maxwelllllllllllll/MH69/Images/CB70 Matrix.png

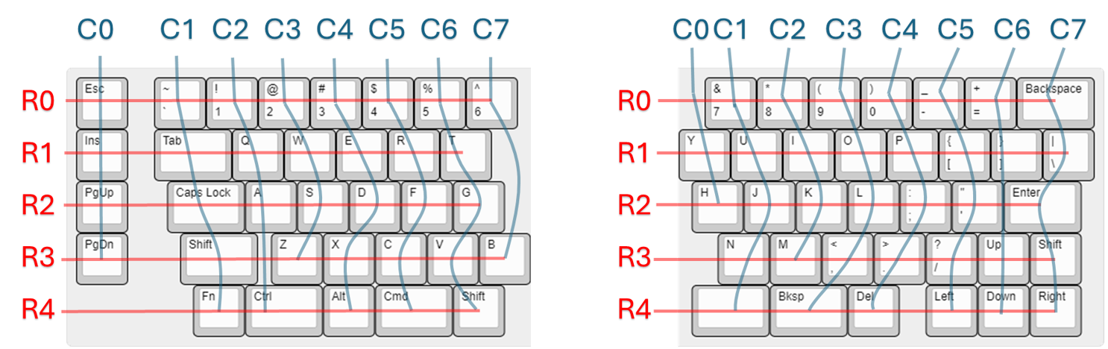
Images/CB70 Matrix.png
