maxwelllllllllllll/MH69/Images/DoubleKeys.png

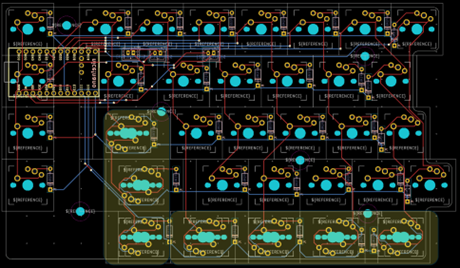
Images/DoubleKeys.png
