maxwelllllllllllll/MH69/Original CB70 Data/Case/Choc-Slim/pic.png

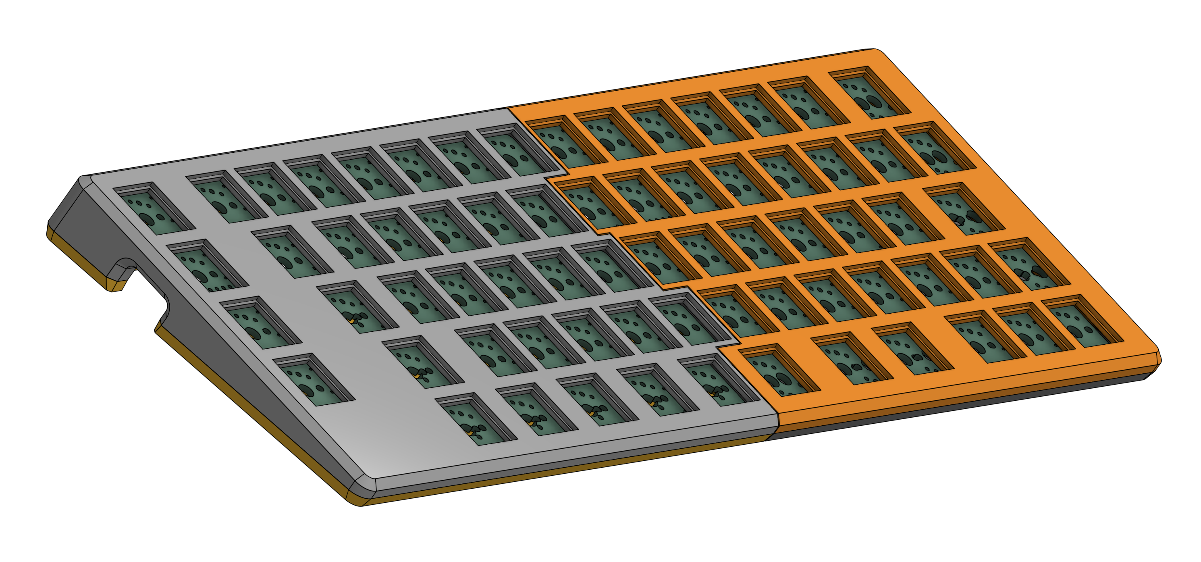
Original CB70 Data/Case/Choc-Slim/pic.png
