maxwelllllllllllll/MH69/Original CB70 Data/Case/Choc/pic.png

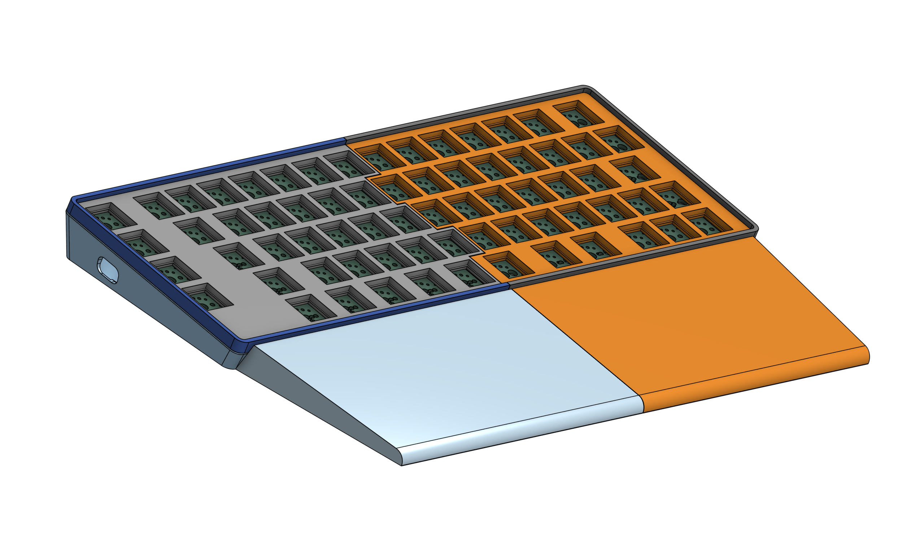
Original CB70 Data/Case/Choc/pic.png
