maxwelllllllllllll/MH69/Original CB70 Data/Case/MX/pic.png

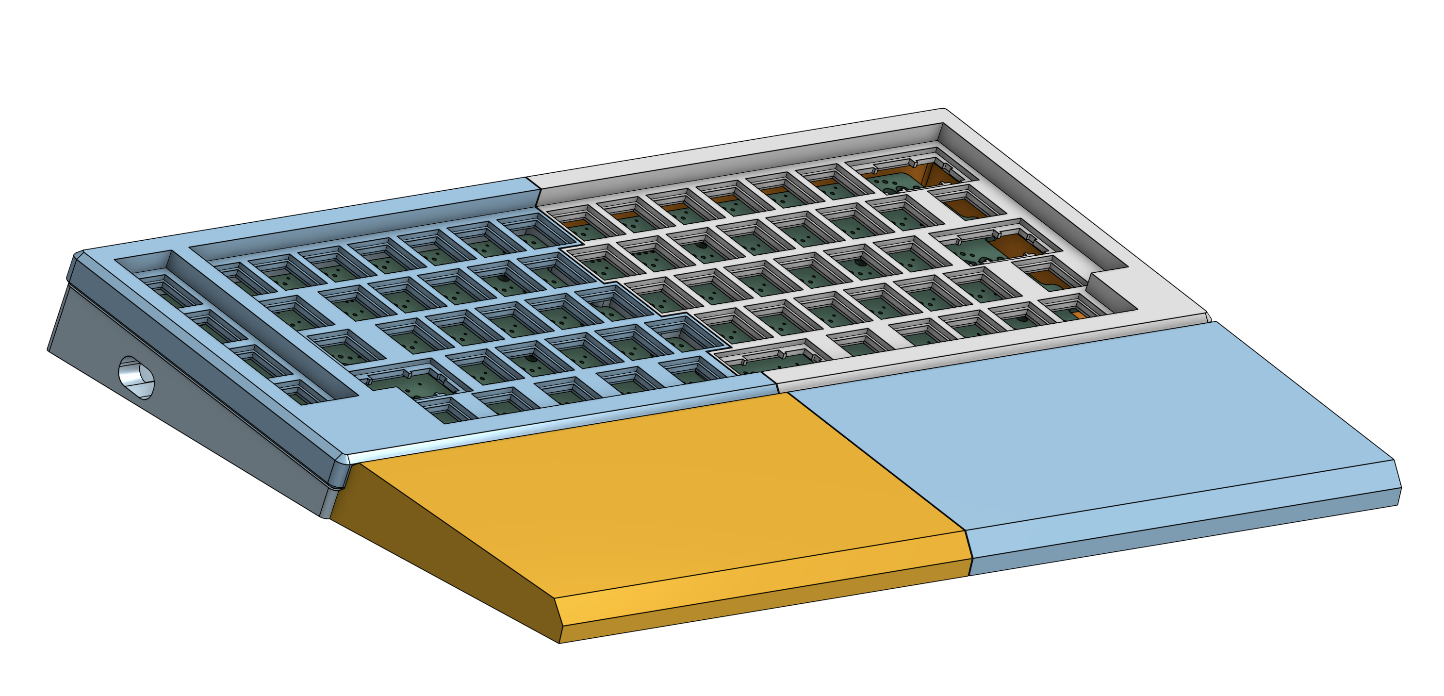
Original CB70 Data/Case/MX/pic.png
