maxwelllllllllllll/MH69/MH69_Data/PCB/MH69-Left/MH69-Left.step

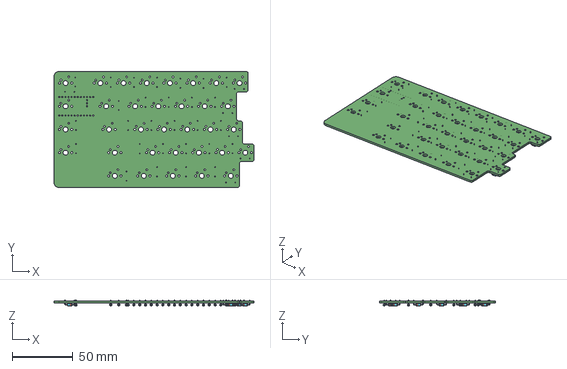
[picture p10: CAD file, 2025-01-18]
MH69_Data/PCB/MH69-Left/MH69-Left.step
164.3 x 95.2 x 5.01 mm
