maxwelllllllllllll/MH69/MH69_Data/PCB/MH69-Right/MH69-Right.step

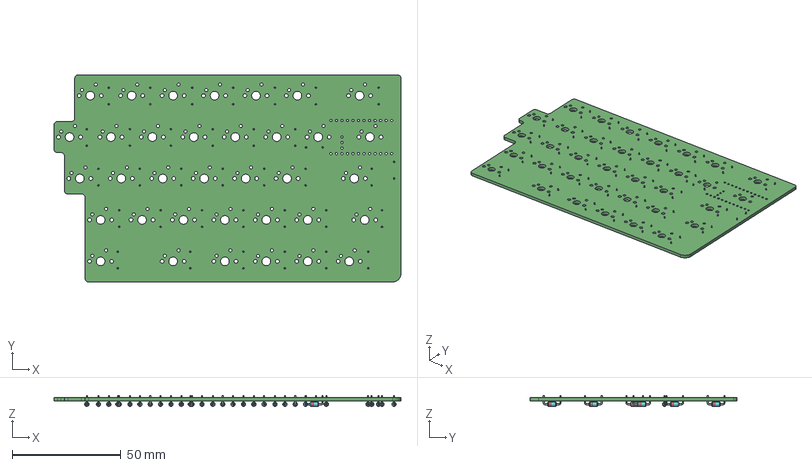
[picture p11: CAD file, 2025-01-18]
MH69_Data/PCB/MH69-Right/MH69-Right.step
159.5 x 95.2 x 5.01 mm
