maxwelllllllllllll/MH69/Original CB70 Data/Case/Choc-Slim/Choc-Slim - Right Plate.stl

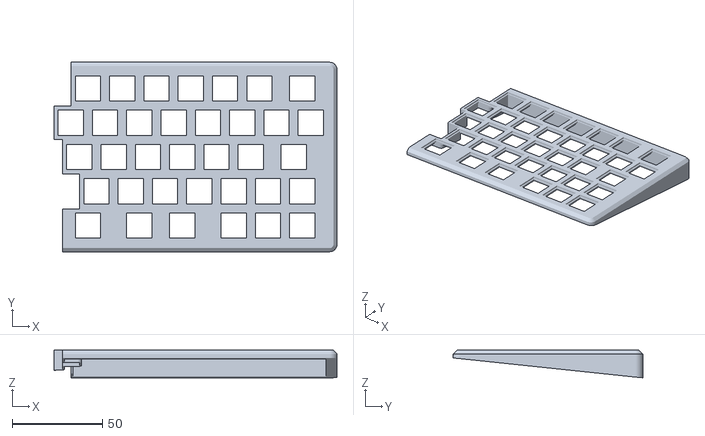
[picture p12: CAD file, 2025-01-18]
Original CB70 Data/Case/Choc-Slim/Choc-Slim - Right Plate.stl
156.8 x 105.0 x 15.4
