maxwelllllllllllll/MH69/Original CB70 Data/Case/Choc/Choc - Left Base.stl

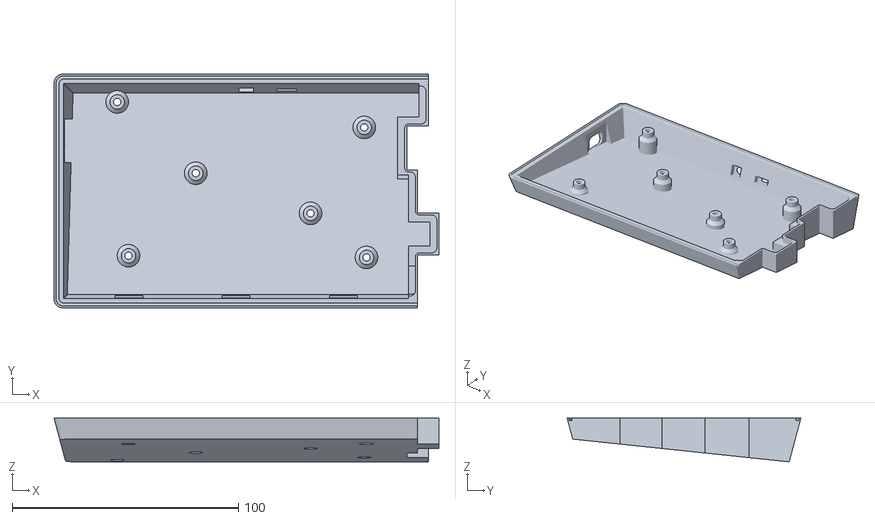
[picture p13: CAD file, 2025-01-18]
Original CB70 Data/Case/Choc/Choc - Left Base.stl
170.3 x 103.4 x 19.3
