maxwelllllllllllll/MH69/Original CB70 Data/Case/MX/MX - Left Top.stl

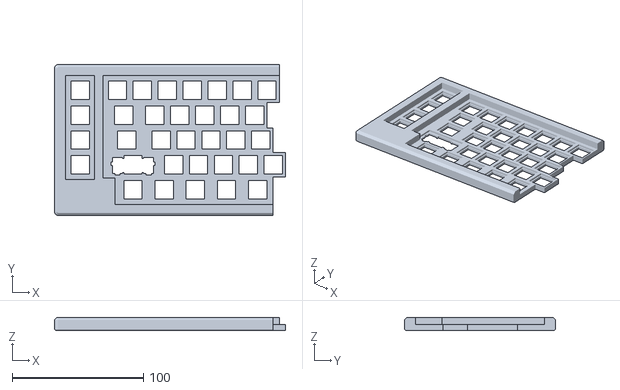
[picture p14: CAD file, 2025-01-18]
Original CB70 Data/Case/MX/MX - Left Top.stl
176.1 x 115.0 x 10.2
