maxwelllllllllllll/MH69/Original CB70 Data/Case/Choc/Choc - Left Plate.stl

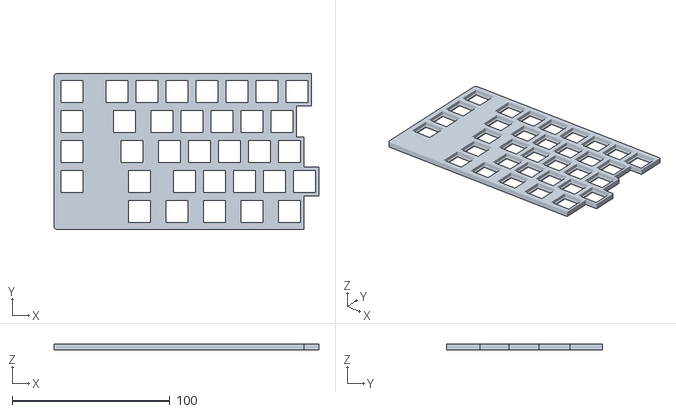
[picture p16: CAD file, 2025-01-18]
Original CB70 Data/Case/Choc/Choc - Left Plate.stl
168.1 x 99.0 x 3.80
