maxwelllllllllllll/MH69/Original CB70 Data/Case/MX/MX - Right Base.stl

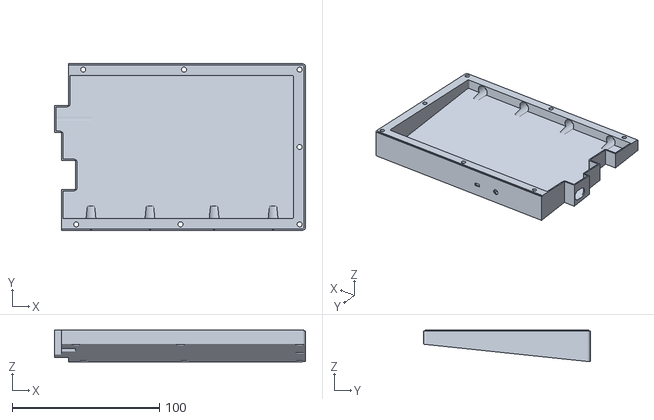
[picture p17: CAD file, 2025-01-18]
Original CB70 Data/Case/MX/MX - Right Base.stl
170.3 x 113.0 x 21.4
