maxwelllllllllllll/MH69/Original CB70 Data/Case/Choc-Slim/Choc-Slim - Right Base.stl

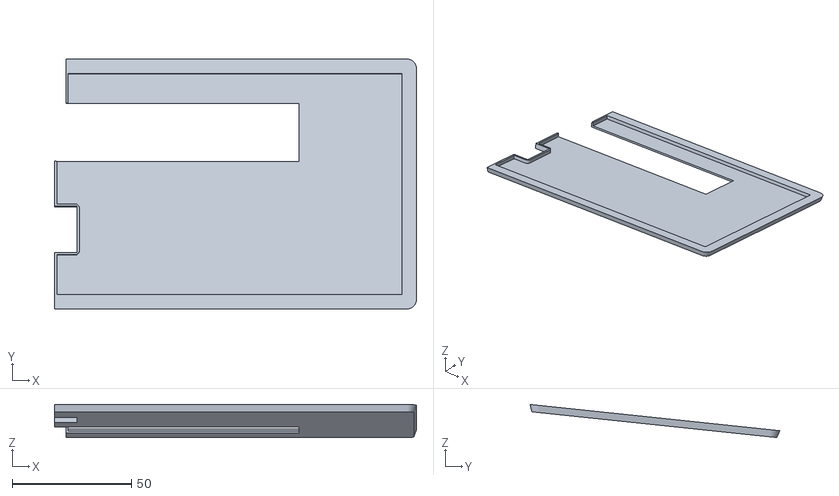
[picture p18: CAD file, 2025-01-18]
Original CB70 Data/Case/Choc-Slim/Choc-Slim - Right Base.stl
152.1 x 105.0 x 13.9
