maxwelllllllllllll/MH69/Original CB70 Data/Case/Choc/Choc - Right Top.stl

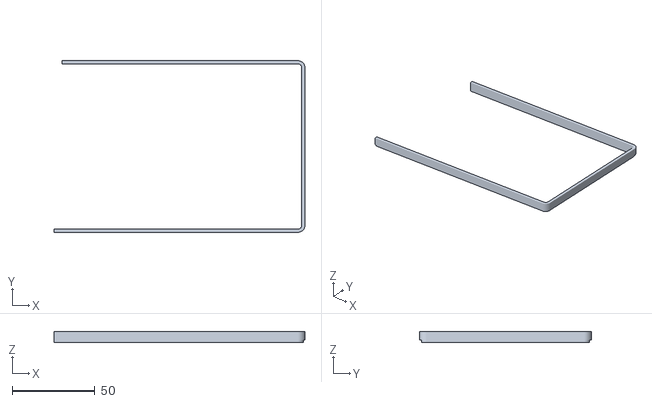
[picture p19: CAD file, 2025-01-18]
Original CB70 Data/Case/Choc/Choc - Right Top.stl
151.2 x 103.4 x 6.80
