maxwelllllllllllll/MH69/Original CB70 Data/Case/MX/MX - Left Base.stl

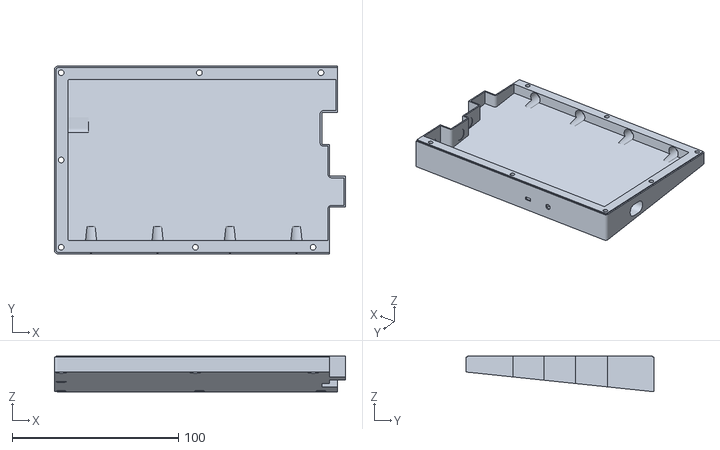
[picture p20: CAD file, 2025-01-18]
Original CB70 Data/Case/MX/MX - Left Base.stl
175.1 x 113.0 x 21.4
