maxwelllllllllllll/MH69/Original CB70 Data/Case/Choc-Slim/Choc-Slim - Left Plate.stl

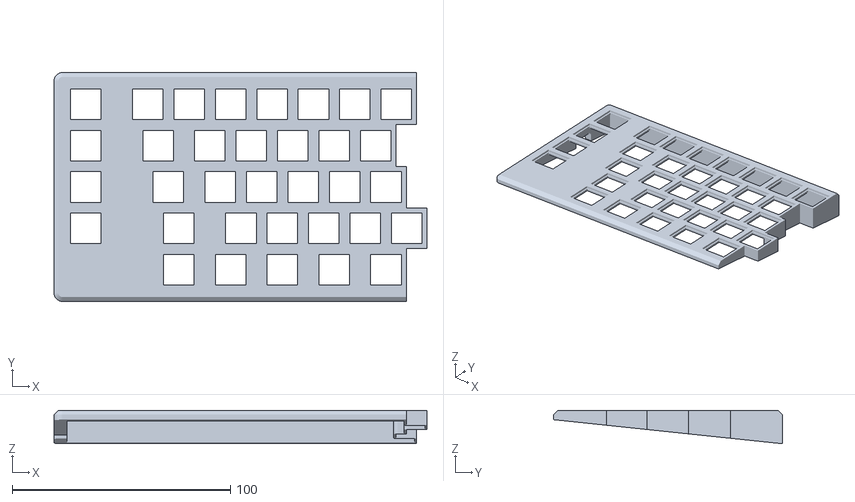
[picture p21: CAD file, 2025-01-18]
Original CB70 Data/Case/Choc-Slim/Choc-Slim - Left Plate.stl
171.1 x 105.0 x 15.4
