maxwelllllllllllll/MH69/Original CB70 Data/Case/Choc/Choc - Right base.stl

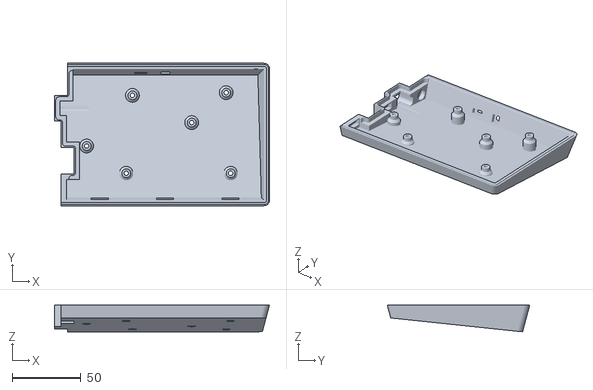
[picture p22: CAD file, 2025-01-18]
Original CB70 Data/Case/Choc/Choc - Right base.stl
156.0 x 103.4 x 19.3
