maxwelllllllllllll/MH69/Original CB70 Data/Case/MX/MX - Right Top.stl

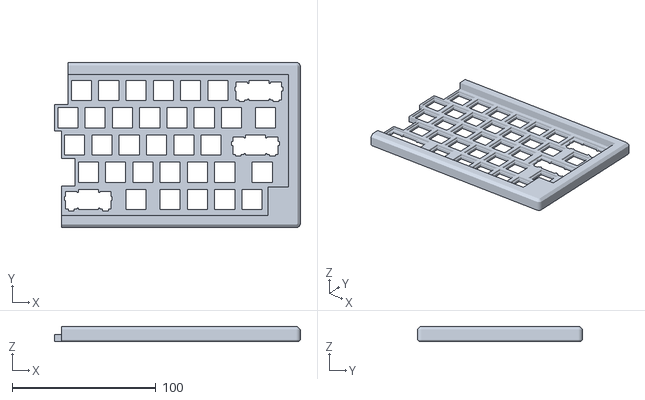
[picture p23: CAD file, 2025-01-18]
Original CB70 Data/Case/MX/MX - Right Top.stl
171.3 x 115.0 x 10.2
