maxwelllllllllllll/MH69/Original CB70 Data/Case/Choc/Choc - Right Wrist Rest.stl

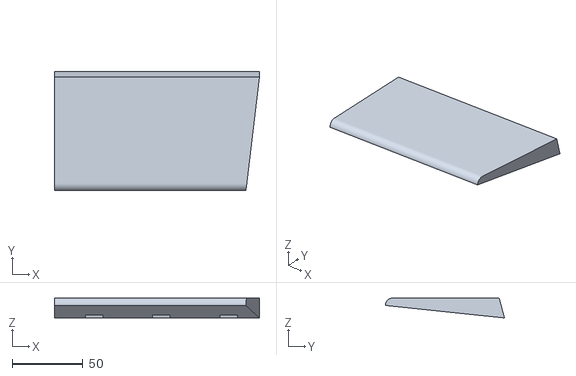
[picture p24: CAD file, 2025-01-18]
Original CB70 Data/Case/Choc/Choc - Right Wrist Rest.stl
144.7 x 84.0 x 14.1
