maxwelllllllllllll/MH69/Original CB70 Data/Case/MX/MX - Left Wrist Rest.stl

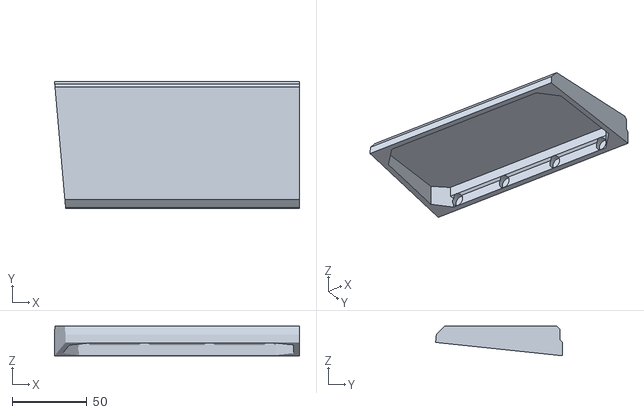
[picture p25: CAD file, 2025-01-18]
Original CB70 Data/Case/MX/MX - Left Wrist Rest.stl
163.6 x 84.7 x 19.7
