maxwelllllllllllll/MH69/Original CB70 Data/Case/Choc/Choc - Left Top.stl

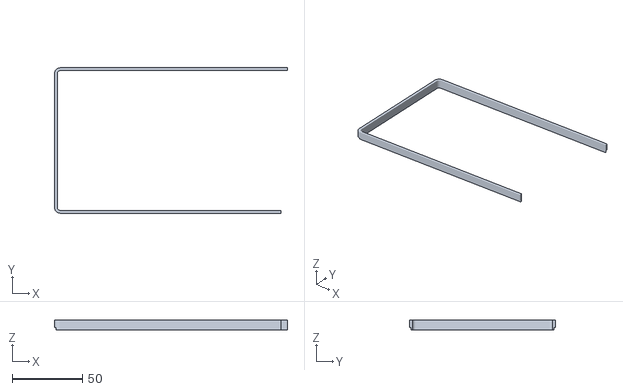
[picture p26: CAD file, 2025-01-18]
Original CB70 Data/Case/Choc/Choc - Left Top.stl
165.5 x 103.4 x 6.80
