maxwelllllllllllll/MH69/Original CB70 Data/Case/MX/MX - Right Wrist Rest.stl

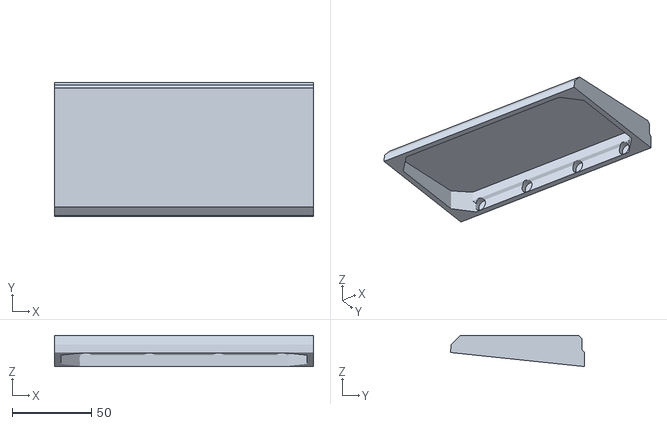
[picture p27: CAD file, 2025-01-18]
Original CB70 Data/Case/MX/MX - Right Wrist Rest.stl
163.6 x 84.7 x 19.7
