maxwelllllllllllll/MH69/Original CB70 Data/Case/Choc/Choc - Left Wrist Rest.stl

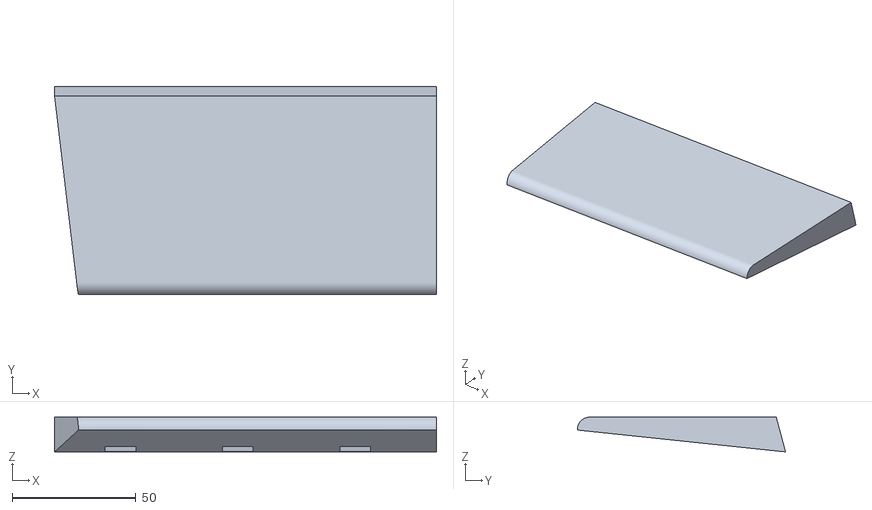
[picture p28: CAD file, 2025-01-18]
Original CB70 Data/Case/Choc/Choc - Left Wrist Rest.stl
154.2 x 84.0 x 14.1
