maxwelllllllllllll/MH69/Original CB70 Data/Case/Choc/Choc - Right Plate.stl

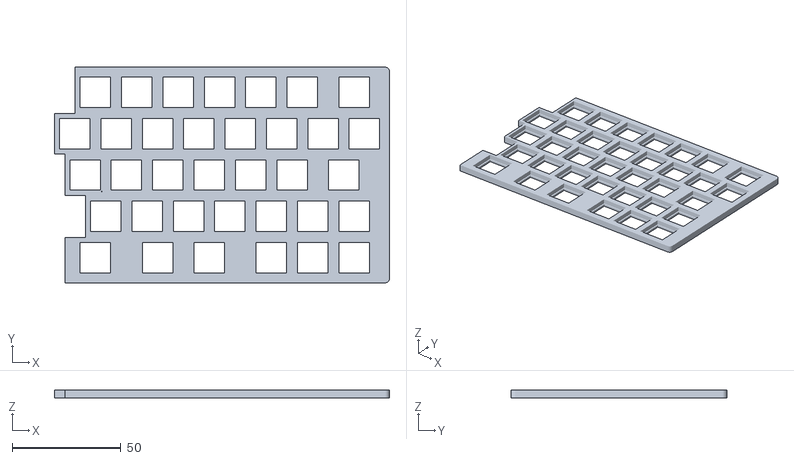
[picture p29: CAD file, 2025-01-18]
Original CB70 Data/Case/Choc/Choc - Right Plate.stl
153.8 x 99.0 x 3.80
