maxwelllllllllllll/MH69/MH69_Data/PCB/MH69-Right/MH69-Right.kicad_pcb

## KiCad design MH69_Data/PCB/MH69-Right/MH69-Right.kicad_pcb (2025-01-29)

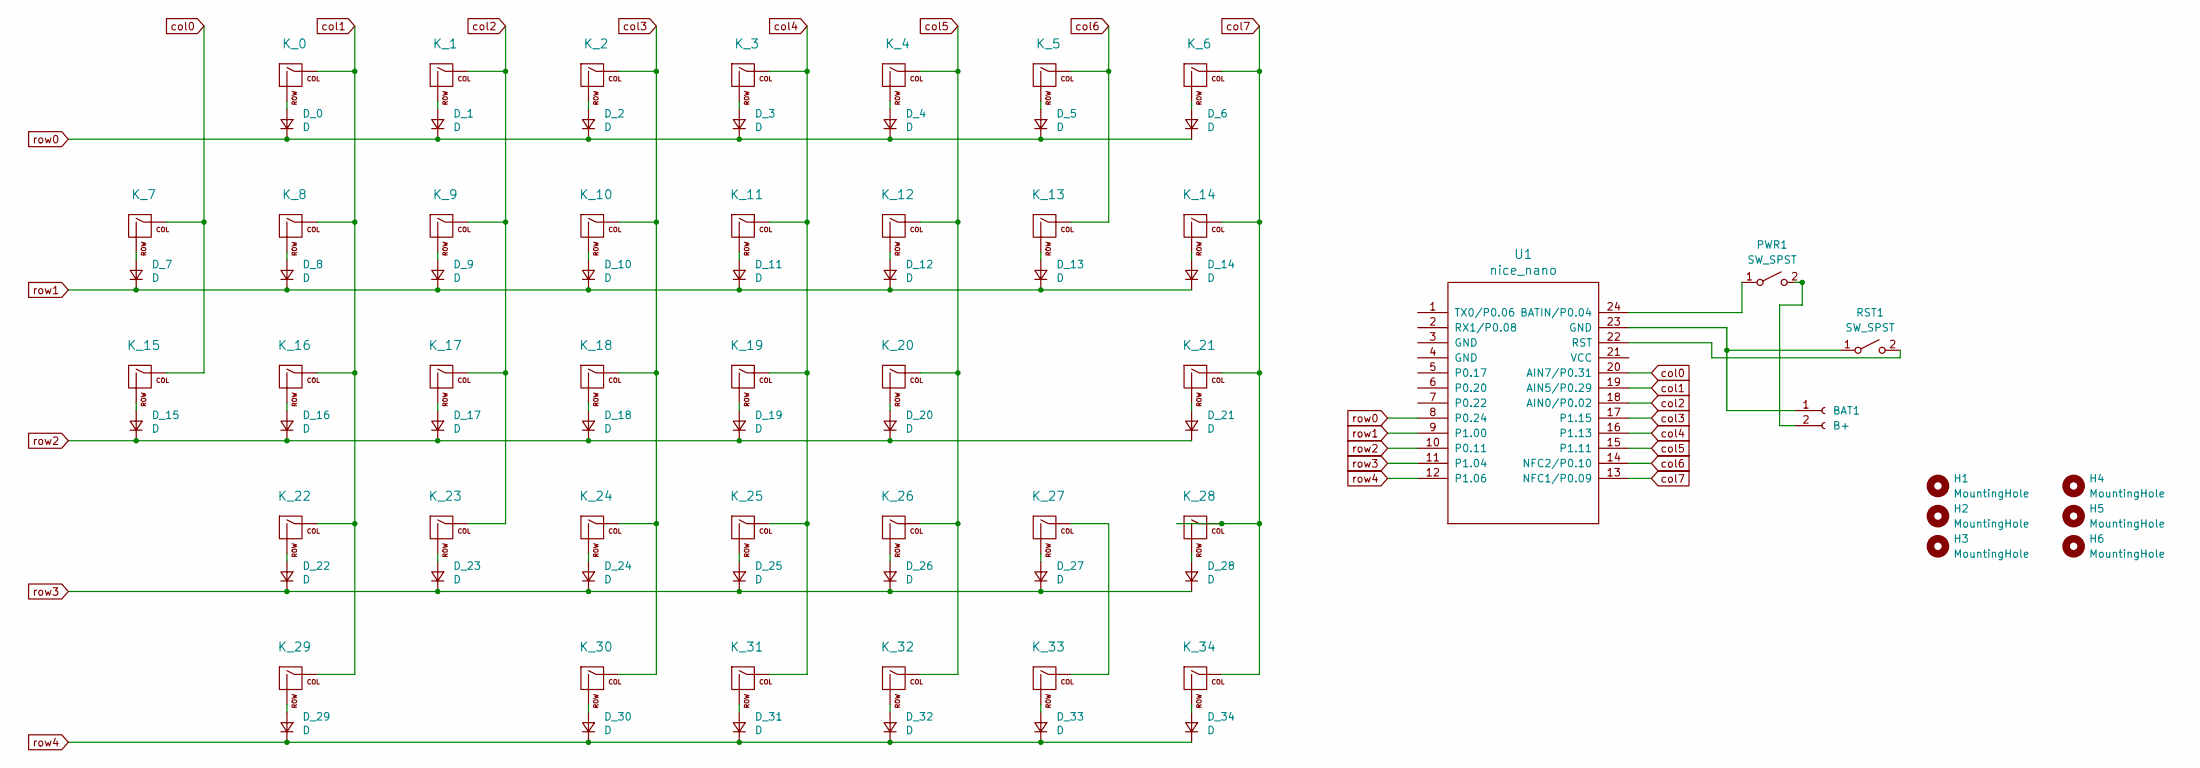
[picture p30: schematic MH69-Right.kicad_sch]

Parts:
BAT1: B+; JST_PH_B2B-PH-K_1x02_P2.00mm_Vertical
D_0, D_1, D_2, D_3, D_4, D_5, D_6, D_7, D_8, D_9, D_10, D_11, D_12, D_13, D_14, D_15, D_16, D_17, D_18, D_19, D_20, D_21, D_22, D_23, D_24, D_25, D_26, D_27, D_28, D_29, D_30, D_31, D_32, D_33, D_34: D; Diode_DO-35
H1, H2, H3, H4, H5, H6: MountingHole; MountingHole_3.2mm_M3
K_0, K_1, K_2, K_3, K_4, K_5, K_7, K_8, K_9, K_10, K_11, K_12, K_13, K_14, K_15, K_16, K_17, K_18, K_19, K_20, K_22, K_23, K_24, K_25, K_26, K_27, K_28, K_31, K_32, K_33, K_34: KEYSW; SW_Hotswap_Kailh_Choc_V1_Plated_1.00u
K_6, K_21, K_29, K_30: KEYSW; SW_Hotswap_Kailh_Choc_V1_Plated_1.50u
PWR1: SW_SPST; JST_PH_B2B-PH-K_1x02_P2.00mm_Vertical
RST1: SW_SPST; JST_PH_B2B-PH-K_1x02_P2.00mm_Vertical
U1: nice_nano; nice_nano_no_mid

Connections:
unnamed: BAT1.1, RST1.1 (A), U1.23 (GND)
unnamed: BAT1.2, PWR1.2 (B)
unnamed: D_0.2 (A), K_0.2 (ROW)
unnamed: D_1.2 (A), K_1.2 (ROW)
unnamed: D_2.2 (A), K_2.2 (ROW)
unnamed: D_3.2 (A), K_3.2 (ROW)
unnamed: D_4.2 (A), K_4.2 (ROW)
unnamed: D_5.2 (A), K_5.2 (ROW)
unnamed: D_6.2 (A), K_6.2 (ROW)
unnamed: D_7.2 (A), K_7.2 (ROW)
unnamed: D_8.2 (A), K_8.2 (ROW)
unnamed: D_9.2 (A), K_9.2 (ROW)
unnamed: D_10.2 (A), K_10.2 (ROW)
unnamed: D_11.2 (A), K_11.2 (ROW)
unnamed: D_12.2 (A), K_12.2 (ROW)
unnamed: D_13.2 (A), K_13.2 (ROW)
unnamed: D_14.2 (A), K_14.2 (ROW)
unnamed: D_15.2 (A), K_15.2 (ROW)
unnamed: D_16.2 (A), K_16.2 (ROW)
unnamed: D_17.2 (A), K_17.2 (ROW)
unnamed: D_18.2 (A), K_18.2 (ROW)
unnamed: D_19.2 (A), K_19.2 (ROW)
unnamed: D_20.2 (A), K_20.2 (ROW)
unnamed: D_21.2 (A), K_21.2 (ROW)
unnamed: D_22.2 (A), K_22.2 (ROW)
unnamed: D_23.2 (A), K_23.2 (ROW)
unnamed: D_24.2 (A), K_24.2 (ROW)
unnamed: D_25.2 (A), K_25.2 (ROW)
unnamed: D_26.2 (A), K_26.2 (ROW)
unnamed: D_27.2 (A), K_27.2 (ROW)
unnamed: D_28.2 (A), K_28.2 (ROW)
unnamed: D_29.2 (A), K_29.2 (ROW)
unnamed: D_30.2 (A), K_30.2 (ROW)
unnamed: D_31.2 (A), K_31.2 (ROW)
unnamed: D_32.2 (A), K_32.2 (ROW)
unnamed: D_33.2 (A), K_33.2 (ROW)
unnamed: D_34.2 (A), K_34.2 (ROW)
unnamed: K_27.1 (COL), K_33.1 (COL)
unnamed: PWR1.1 (A), U1.24 (BATIN/P0.04)
unnamed: RST1.2 (B), U1.22 (RST)
col0: K_7.1 (COL), K_15.1 (COL), U1.20 (AIN7/P0.31)
col1: K_0.1 (COL), K_8.1 (COL), K_16.1 (COL), K_22.1 (COL), K_29.1 (COL), U1.19 (AIN5/P0.29)
col2: K_1.1 (COL), K_9.1 (COL), K_17.1 (COL), K_23.1 (COL), U1.18 (AIN0/P0.02)
col3: K_2.1 (COL), K_10.1 (COL), K_18.1 (COL), K_24.1 (COL), K_30.1 (COL), U1.17 (P1.15)
col4: K_3.1 (COL), K_11.1 (COL), K_19.1 (COL), K_25.1 (COL), K_31.1 (COL), U1.16 (P1.13)
col5: K_4.1 (COL), K_12.1 (COL), K_20.1 (COL), K_26.1 (COL), K_32.1 (COL), U1.15 (P1.11)
col6: K_5.1 (COL), K_13.1 (COL), U1.14 (NFC2/P0.10)
col7: K_6.1 (COL), K_14.1 (COL), K_21.1 (COL), K_28.1 (COL), K_34.1 (COL), U1.13 (NFC1/P0.09)
row0: D_0.1 (K), D_1.1 (K), D_2.1 (K), D_3.1 (K), D_4.1 (K), D_5.1 (K), D_6.1 (K), U1.8 (P0.24)
row1: D_7.1 (K), D_8.1 (K), D_9.1 (K), D_10.1 (K), D_11.1 (K), D_12.1 (K), D_13.1 (K), D_14.1 (K), U1.9 (P1.00)
row2: D_15.1 (K), D_16.1 (K), D_17.1 (K), D_18.1 (K), D_19.1 (K), D_20.1 (K), D_21.1 (K), U1.10 (P0.11)
row3: D_22.1 (K), D_23.1 (K), D_24.1 (K), D_25.1 (K), D_26.1 (K), D_27.1 (K), D_28.1 (K), U1.11 (P1.04)
row4: D_29.1 (K), D_30.1 (K), D_31.1 (K), D_32.1 (K), D_33.1 (K), D_34.1 (K), U1.12 (P1.06)

Board: 2 copper layers, 80 parts (38 on the bottom side), 53 nets, no tracks yet.
