maxwelllllllllllll/MH69/(commit log)

2025-01-18 Adding all of CB files
    [Choc - Left Base.stl, Choc - Left Plate.stl, Choc - Left Top.stl, Choc - Left Wrist Rest.stl, Choc - Right Plate.stl, Choc - Right Top.stl, Choc - Right Wrist Rest.stl, Choc - Right base.stl]
2025-01-19 Initial PCB file additions
    [MH69-Left-B_Cu.gbr, MH69-Left-B_Mask.gbr, MH69-Left-B_Paste.gbr, MH69-Left-B_SilkS.gbr, MH69-Left-Edge_Cuts.gbr, MH69-Left-F_Cu.gbr, MH69-Left-F_Mask.gbr, MH69-Left-F_Paste.gbr]
2025-01-19 Added Kailh Plated 1Us to Left
    [MH69-Left.kicad_pcb, MH69-Left.kicad_sch]
2025-01-19 some kicad work
    [MH69-Left.kicad_pcb]
2025-01-20 Left side layout progress
    [MH69-Left.kicad_pcb]
2025-01-20 updated left number row
    [MH69-Left.kicad_pcb]
2025-01-20 tiny change to a single diode
    [MH69-Left.kicad_pcb]
2025-01-20 closed Kicad
2025-01-22 very minor layout tweaking
    [MH69-Left.kicad_pcb]
2025-01-23 fine touches on edge cuts mostly
    [MH69-Left.kicad_pcb]
2025-01-23 Updated some libs
    [MH69-Left.kicad_pcb]
2025-01-24 Updated footprint
2025-01-24 updated diode locations
    [MH69-Left.kicad_pcb]
2025-01-26 completed left side diode placement
    [MH69-Left.kicad_pcb]
2025-01-26 started left routing
    [MH69-Left.kicad_pcb]
2025-01-27 completed all routing for left except power etc
    [MH69-Left.kicad_pcb]
2025-01-27 THE BIG CHANGE - schematic and PCB layout
    [MH69-Left.kicad_pcb, MH69-Left.kicad_sch]
2025-01-28 Left side finished?
    [MH69-Left.kicad_pcb, MH69-Left.kicad_sch]
2025-01-29 Finished Left and moving on to Right
    [MH69-Left.kicad_pcb, MH69-Right.kicad_pcb, MH69-Right.kicad_sch]
2025-01-29 Footprint Lib Move
